RMResearch/OpenMPD_Hardware/README.md

##Main guide in the root folder##

Case designs inside 'cases' have folders for a few designs, NxN where N is the number of boards on the top and bottom of the case

Electronics boards inside 'electronics'
