RMResearch/OpenMPD_Hardware/FPGA_3.4.2/notes.docx

The project: .qpf file

# Top:

Groups all other components, and describes coneections to sub-components and FPGA IO/

## Parallel_Receiver:

Receives USB data and acknowledges (through a PIN).
