RMResearch/OpenMPD_Hardware/Electronics/Controller/Controller Board BOM.xlsx

Sheet: Costing
 | Ident / Locations / Customer Part No. | Description | IF2 Part | Supplier | Part Number | Qty | Cost | Total | Stock | Assy Time | Total Time | Rosh | Reach | Req. | MOQ | EXCESS STOCK VALUE | Assy | Additional | Notes
1 | J3, J4 | SAMTEC TSSH-120-01-L-D | CON2551 | TOBY | TSSH-120-01-L-D | 2 | £2.10 | £4.20 | 1WK | 200.00 | 400.00 |  |  |  |  | £0.00
2 | USB CABLE | Tensility International Corp 10-03678 - USB 2.0, USB 3.2 Gen 2 (USB 3.1 Gen 2, Superspeed+ (USB 3.1)) Cable A Male to C Male 4.92' (1.50m) Shielded | CAB1289 | DIGIKEY | 839-10-03678-ND | 1 | £4.40 | £4.40 | 554 | 60.00 | 60.00 |  |  |  |  | £0.00
3 | AUX | SAMTEC STMM-115-02-L-D | CON2552 | TOBY | STMM-115-02-L-D | 1 | £2.58 | £2.58 | 86 | 150.00 | 150.00
4 | C1 | WALSIN 0805B334K250CT SMD Multilayer Ceramic Capacitor, 0.33 µF, 25 V, 0805 [2012 Metric], ± 10%, X7R | CAP1201 | FARNELL | 2496973RL | 1 | £0.03 | £0.03 | 1410 | 20.00 | 20.00
5 | C2, C7 | AVX 08055C104KAT2A SMD Multilayer Ceramic Capacitor, 0.1 µF, 50 V, 0805 [2012 Metric], ± 10%, X7R | CAP0461 | FARNELL | 499687 | 2 | £0.03 | £0.06 | 797434 | 20.00 | 40.00
6 | C5 | RS PRO 4700μF Electrolytic Capacitor 50V dc, Through Hole | CAP1202 | RSC | 1701262 | 1 | £1.58 | £1.58 | 50 | 45.00 | 45.00
7 | C6 | TAJC106K010RNJ AVX CORPORATION TAJ TANT 10UF 10V 10% CASE C | CAP1096 | ANGLIA COMPONENTS | TAJC106K010RNJ | 1 | £0.10 | £0.10 | 48600 | 20.00 | 20.00 |  |  |  |  | £0.00
8 | C8 | KEMET R82DC3330AA60K - Film Capacitors 63V 0.33uF 10% LS=5mm AEC-Q200 | CAP1203 | MOUSER | 80-R82DC3330AA60K | 1 | £0.11 | £0.11 | 744 | 30.00 | 30.00 |  |  |  |  | £0.00
9 | D1, D2 | DIODES INC S1KB-13-F | DID0634 | RSC | 8855558 | 2 | £0.10 | £0.20 | 3455 | 30.00 | 60.00
10 | HH8, HH9 | SAMTEC SQW-116-01-F-D | CON2553 | TOBY | SQW-116-01-F-D | 2 | £1.95 | £3.90 | 5 DAYS | 160.00 | 320.00
11 | J1, J2 | SAMTEC SQW-127-01-F-D | CON2554 | TOBY | SQW-127-01-F-D | 2 | £3.30 | £6.60 | 5 DAYS | 540.00 | 1080.00
12 | J7, J8 | SAMTEC SSW-111-01-G-S PCB Receptacle, Board-to-Board, 2.54 mm, 1 Rows, 11 Contacts, Through Hole Mount, SSW Series | CON2555 | FARNELL | 2984477 | 2 | £0.80 | £1.60 | 52 | 100.00 | 200.00
13 | K1 | TE PE014003 - General Purpose Relays PE014003 | MEP1082 | MOUSER | 655-PE014003 | 1 | £2.30 | £2.30 | 665 | 45.00 | 45.00 |  |  |  |  | £0.00
14 | L1 | BOURNS 2324-H-RC TOROIDAL INDUCTOR, 1MH, 2.4A, 15% | MEP1083 | FARNELL | 1189587 | 1 | £2.00 | £2.00 | 176 | 30.00 | 30.00 |  |  |  |  | £0.00
 | L1 | HOT MELT GLUE | COS0023 | FARNELL | 704-8117 | 0.01 | £20.00 | £0.20 | STOCK | 45.00 | 45.00
15 | NOT FITTED TO PCB ONLY SUPPLIED WITH CABLE | SAMTEC FFSD-05-D-72.00-01-N | CAB1290 | RSC | 1800017 | 1 | £12.92 | £12.92 | 3 | 60.00 | 60.00 |  |  |  |  | £0.00
18 | PF1 | LITTLEFUSE 1812L110/33MR - Resettable Fuses - PPTC PTC 33V 1.10A POLY SURF MOUNT | MEP1084 | MOUSER | 576-1812L110/33MR | 1 | £0.33 | £0.33 | 9021 | 30.00 | 30.00 |  |  |  |  | £0.00 |  | ASK QUESTION
19 | PF2 | LITTLEFUSE 2920L100PR - Resettable Fuses - PPTC 1.10A 33V 2920 | MEP1085 | MOUSER | 576-2920L100 | 1 | £0.38 | £0.38 | 3654 | 30.00 | 30.00 |  |  |  |  | £0.00 |  | ASK QUESTION
20 | PWR | PCB Mount DC Power Socket 2.1mm Right Angle 2.5A | CON2556 | https://www.hobbytronics.co.uk/ | PRT-00119 | 1 | £0.60 | £0.60 | 8910 | 45.00 | 45.00 |  |  |  |  | £0.00
21 | Q1 | 2N7000 Power MOSFET, N Channel, 60 V, 200 mA, 5 ohm, TO-92, Through Hole | SMC0444 | FARNELL | 9845178 | 1 | £0.10 | £0.10 | 43677 | 45.00 | 45.00 |  |  |  |  | £0.00
22 | UM1 | ADAFRUIT 2264 - Interface Development Tools Adafruit FT232H Breakout - General Purpose USB to GPIO SPI I2C - USB C & Stemma QT | SMC1540 | MOUSER | 485-2264 | 1 | £11.39 | £11.39 | 323 | 120.00 | 120.00 |  |  |  |  | £0.00
23 | VR1 | MURATA OKI-78SR-5/1.5-W36-C - Non-Isolated DC/DC Converters 7.5W 24Vin 5Vout1 1.5A SIP Non-Iso | MEP1086 | MOUSER | 580-OKI78SR5/1.5W36C | 1 | £3.18 | £3.18 | 4195 | 45.00 | 45.00 |  |  |  |  | £0.00
24 | SYNC | SAMTEC SHF-105-01-L-D-RA | CON2557 | TOBY | SHF-105-01-L-D-RA | 1 | £1.71 | £1.71 | 1WK | 100.00 | 100.00 |  |  |  |  | £0.00
25 | VS | WURTH 150080RS75000 | DID0635 | MOUSER | 710-150080RS75000 | 1 | £0.13 | £0.13 | 36635 | 45.00 | 45.00 |  |  |  |  | £0.00
26 | Vin | WURTH 150080VS75000 | DID0636 | MOUSER | 710-150080VS75000 | 1 | £0.13 | £0.13 | 20484 | 45.00 | 45.00 |  |  |  |  | £0.00
27 | Vcc | WURTH 150080BS75000 | DID0637 | MOUSER | 710-150080BS75000 | 1 | £0.13 | £0.13 | 12876 | 45.00 | 45.00 |  |  |  |  | £0.00
28 | Vin SYNC, MS, REF | 2.54mm PITCH 36W SIL PIN HEADER STRIP GOLD PLATED | CON0151 | INTERFACE 2 |  | 1 | £1.50 | £1.50 | STOCK | 30.00 | 180.00 |  |  |  |  | £0.00
29 | R1, R2 | BOURNS CR0805-FX-1501ELF SMD Chip Resistor, 1.5 kohm, ± 1%, 125 mW, 0805 [2012 Metric], Thick Film, General Purpose | RES1766 | FARNELL | 2333560RL | 2 | £0.01 | £0.03 | 1330 | 20.00 | 40.00
30 | R6 | CRCW0805330RFKEA SMD Chip Resistor, 330 ohm, ± 1%, 125 mW, 0805 [2012 Metric], Thick Film, General Purpose | RES0755 | FARNELL | 1469918 | 1 | £0.02 | £0.02 | STOCK | 30.00 | 30.00
31 | R3, R5, R7, R11, R12 | Bourns 10kΩ, 0805 (2012M) Thick Film SMD Resistor ±1% 0.25W - CRS0805-FX-1002ELF | RES1660 | RSC | 8672934 | 5 | £0.06 | £0.32 | 550 | 20.00 | 100.00
32 | Vin SYNC, MS | Amphenol FCI 63429-202LF, Mini-Jump Jumper Female White Shunt 2 Way 1 Row 2.54mm Pitch | MEP1087 | RSC | 8632721 | 2 | £0.13 | £0.25 | STOCK | 20.00 | 40.00
33 | FPGA | COREEP4CE10, ALTERA CORE BOARD | SMC1541 | WAVE SHARE | CoreEP4CE10 | 1 | £22.72 | £22.72 | TBC | 120.00 | 120.00
34 | POWER SUPPLY | Ansmann 12 V dc, 15 V dc, 18 V dc, 19 V dc, 20 V dc, 22 V dc, 24 V dc Power Supply, 1 A, 1.2 A, 1.35 A, 1.4 A, 1.5 A | MEP1088 | RSC | 7023265 | 1 | £20.96 | £20.96 | 22 | 180.00 | 180.00
35 | PCB | PCB | CUS0797 | BEN |  | 1 | £0.00 | £0.00 | STOCK | 600.00 | 600.00

Sheet: Labour only
 |  | Price checked means we have reviewed cheapest buying option on the day costing was created
 |  | All prices are only a guide to what can be paid per component, if a cheaper option exists on Caliach it should be used.
 | Mandatory QMS Information Questions
 | Statutory, Regulatory and Environmental requirements to be considered ? |  |  | All parts supplied to conform to RoHS, and Reach Regulations including conflict minerals act.
 | Any requirements specified by the customer, including the requirements for delivery and post-delivery activities?
 | Customer | BEN @ UCL
 | Customer Part No. | DAUGHTER BOARD (CONTROLLER ASSEMBLY)
 | Interface 2 Part No. | IF25301
 | Issue No. | 01
 | Batch size | 1.00
 | Unit Cost | £45.67
 | Order Value | £45.67
 | Buy Value - Batch | £0.00
 | Labour required in hours | 1.52
 | Value | £32.73
 | Ident / Locations / Customer Part No. | Description | IF2 Part | Supplier | Part Number | Qty | Cost | Total | Stock | Assy Time | Total Time | Rosh | Reach | Req. | MOQ | EXCESS STOCK VALUE | Assy | Additional | Notes
1 | J3, J4 | SAMTEC TSSH-120-01-L-D | CON2551 | TOBY | TSSH-120-01-L-D | 2 |  | £0.00 | 1WK | 200.00 | 400.00 |  |  |  |  | £0.00
2 | USB CABLE | Tensility International Corp 10-03678 - USB 2.0, USB 3.2 Gen 2 (USB 3.1 Gen 2, Superspeed+ (USB 3.1)) Cable A Male to C Male 4.92' (1.50m) Shielded |  | DIGIKEY | 839-10-03678-ND | 1 |  | £0.00 | 554 | 60.00 | 60.00 |  |  |  |  | £0.00
3 | AUX | SAMTEC STMM-115-02-L-D |  | MOUSER | 200-STMM11502LD | 1 |  | £0.00 | 86 | 150.00 | 150.00
4 | C1 | WALSIN 0805B334K250CT SMD Multilayer Ceramic Capacitor, 0.33 µF, 25 V, 0805 [2012 Metric], ± 10%, X7R |  | FARNELL | 2496973RL | 1 |  | £0.00 | 1410 | 20.00 | 20.00
5 | C2, C7 | AVX 08055C104KAT2A SMD Multilayer Ceramic Capacitor, 0.1 µF, 50 V, 0805 [2012 Metric], ± 10%, X7R | CAP0461 | FARNELL | 499687 | 2 |  | £0.00 | 797434 | 20.00 | 40.00
6 | C5 | RS PRO 4700μF Electrolytic Capacitor 50V dc, Through Hole |  | RSC | 1701262 | 1 |  | £0.00 | 50 | 45.00 | 45.00
7 | C6 | TAJC106K010RNJ AVX CORPORATION TAJ TANT 10UF 10V 10% CASE C |  | ANGLIA COMPONENTS | TAJC106K010RNJ | 1 |  | £0.00 | 48600 | 20.00 | 20.00 |  |  |  |  | £0.00
8 | C8 | KEMET R82DC3330AA60K - Film Capacitors 63V 0.33uF 10% LS=5mm AEC-Q200 |  | MOUSER | 80-R82DC3330AA60K | 1 |  | £0.00 | 744 | 30.00 | 30.00 |  |  |  |  | £0.00
9 | D1, D2 | DIODES INC S1KB-13-F |  | RSC | 8855558 | 2 |  | £0.00 | 3455 | 30.00 | 60.00
10 | HH8, HH9 | SAMTEC SQW-116-01-F-D |  | MOUSER | 200-SQW11601FD | 2 |  | £0.00 | 89 | 160.00 | 320.00
11 | J1, J2 | SAMTEC SQW-127-01-F-D |  | NEWARK | 81P1316 | 2 |  | £0.00 | 100 | 540.00 | 1080.00
12 | J7, J8 | V06 Series Valcon 2.54mm Pitch Single Row PCB Mount Socket |  | TOBY | V06-1x10-SV-GF-1 | 2 |  | £0.00 | 1784 | 100.00 | 200.00
13 | K1 | TE PE014003 - General Purpose Relays PE014003 |  | MOUSER | 655-PE014003 | 1 |  | £0.00 | 665 | 45.00 | 45.00 |  |  |  |  | £0.00
14 | L1 | BOURNS 2324-H-RC TOROIDAL INDUCTOR, 1MH, 2.4A, 15% |  | FARNELL | 1189587 | 1 |  | £0.00 | 176 | 30.00 | 30.00 |  |  |  |  | £0.00
15 | NOT FITTED TO PCB ONLY SUPPLIED WITH CABLE | SAMTEC FFSD-05-D-72.00-01-N |  | RSC | 1800017 | 2 |  | £0.00 | 3 | 60.00 | 120.00 |  |  |  |  | £0.00
18 | PF1 | LITTLEFUSE 1812L110/33MR - Resettable Fuses - PPTC PTC 33V 1.10A POLY SURF MOUNT |  | MOUSER | 576-1812L110/33MR | 1 |  | £0.00 | 9021 | 30.00 | 30.00 |  |  |  |  | £0.00 |  | ASK QUESTION
19 | PF2 | LITTLEFUSE 2920L100PR - Resettable Fuses - PPTC 1.10A 33V 2920 |  | MOUSER | 576-2920L100 | 1 |  | £0.00 | 3654 | 30.00 | 30.00 |  |  |  |  | £0.00 |  | ASK QUESTION
20 | PWR | PCB Mount DC Power Socket 2.1mm Right Angle 2.5A |  | https://www.hobbytronics.co.uk/ | PRT-00119 | 1 |  | £0.00 | 8910 | 45.00 | 45.00 |  |  |  |  | £0.00
21 | Q1 | 2N7000 Power MOSFET, N Channel, 60 V, 200 mA, 5 ohm, TO-92, Through Hole |  | FARNELL | 9845178 | 1 |  | £0.00 | 43677 | 45.00 | 45.00 |  |  |  |  | £0.00
22 | UM1 | ADAFRUIT 2264 - Interface Development Tools Adafruit FT232H Breakout - General Purpose USB to GPIO SPI I2C - USB C & Stemma QT |  | MOUSER | 485-2264 | 1 |  | £0.00 | 323 | 120.00 | 120.00 |  |  |  |  | £0.00
23 | VR1 | MURATA OKI-78SR-5/1.5-W36-C - Non-Isolated DC/DC Converters 7.5W 24Vin 5Vout1 1.5A SIP Non-Iso |  | MOUSER | 580-OKI78SR5/1.5W36C | 1 |  | £0.00 | 4195 | 45.00 | 45.00 |  |  |  |  | £0.00
24 | SYNC | SAMTEC SHF-105-01-L-D-RA |  | MOUSER | 200-SHF10501LDRA | 1 |  | £0.00 | 659 | 100.00 | 100.00 |  |  |  |  | £0.00
25 | VS | WURTH 150080RS75000 |  | MOUSER | 710-150080RS75000 | 1 |  | £0.00 | 36635 | 45.00 | 45.00 |  |  |  |  | £0.00
26 | Vin | WURTH 150080VS75000 |  | MOUSER | 710-150080VS75000 | 1 |  | £0.00 | 20484 | 45.00 | 45.00 |  |  |  |  | £0.00
27 | Vcc | WURTH 150080BS75000 |  | MOUSER | 710-150080BS75000 | 1 |  | £0.00 | 12876 | 45.00 | 45.00 |  |  |  |  | £0.00
28 | Vin SYNC, MS, REF | 2.54mm PITCH 36W SIL PIN HEADER STRIP GOLD PLATED | CON0151 | INTERFACE 2 |  | 1 |  | £0.00 | STOCK | 30.00 | 180.00 |  |  |  |  | £0.00
29 | R1, R2 | BOURNS CR0805-FX-1501ELF SMD Chip Resistor, 1.5 kohm, ± 1%, 125 mW, 0805 [2012 Metric], Thick Film, General Purpose | RES1766 | FARNELL | 2333560RL | 2 |  | £0.00 | 1330 | 20.00 | 40.00
30 | R6 | CRCW0805330RFKEA SMD Chip Resistor, 330 ohm, ± 1%, 125 mW, 0805 [2012 Metric], Thick Film, General Purpose |  | FARNELL | 1469918 | 1 |  | £0.00 | STOCK | 30.00 | 30.00
31 | R3, R5, R7, R11, R12 | Vishay Dale Manufacturer Part Number CRCW080510K0FKEAC 10 kOhms ±1% 0.125W, 1/8W Chip Resistor 0805 (2012 Metric) Thick Film |  | DIGIKEY | 541-3976-6-ND | 5 |  | £0.00 | STOCK | 20.00 | 100.00
32 | Vin SYNC, MS | Amphenol FCI 63429-202LF, Mini-Jump Jumper Female White Shunt 2 Way 1 Row 2.54mm Pitch |  | RSC | 8632721 | 2 |  | £0.00 | STOCK | 20.00 | 40.00
33 | FPGA | COREEP4CE10, ALTERA CORE BOARD |  | WAVE SHARE | CoreEP4CE10 | 1 |  | £0.00 | TBC | 120.00 | 120.00
34 | POWER SUPPLY | HNP 72-UNI Universal power supply, 72 W, out 12 - 24 V |  | GES HmbH | HNP 72-UNI | 1 |  | £0.00 | 22 | 180.00 | 180.00
35 | PCB | PCB |  | BEN |  | 1 |  | £0.00 | STOCK | 600.00 | 600.00
36 |  | PROCUREMENT |  |  |  | 25% |  | £0.00 | LABOUR
37 |  | LABOUR |  |  |  | 74.33 | £0.50 | £37.17 | 1.24
38 |  | INSPECTION |  |  |  | 15.00 | £0.50 | £7.50 | 0.25
39 |  | PACKING |  |  |  | 2.00 | £0.50 | £1.00 | 0.03
40 |  | SM MACHINE PROGRAMMING |  |  |  | 0.00 | £0.50 | £0.00 | 0.00
41 |  | SM MACHINE SET UP |  |  |  | 0.00 | £0.50 | £0.00 | 0.00
42 |  | TOOLING COSTS |  |  |  | £0.00 | 100% | £0.00
43 |  | EXCESS STOCK |  |  |  | £0.00 | 100% | £0.00
44 |  | DELIVERY CHARGES |  | WAVESHARE, HOBBYCRAFT |  | £59.00 | 100% | £0.00
45 |  | TOTAL |  |  |  |  |  | £45.67 | 1.52
 | EXT | SAMTEC SQW-116-01-F-D |  | MOUSER | 200-SQW11601FD | 1 | £2.44 | £2.44 | 89 | 160.00 | 160.00 |  |  |  |  |  |  | FIT IF THERE IS SPACE AFTER 1st BOARD HAS BEEN BUILT.
 |  | SMATEC FFSD-05-01-N IDC Connector, IDC Receptacle, Female, 1.27 mm, 2 Row, 10 Contacts, Cable Mount |  | FARNELL | 1753841 | 2 | £3.65 | £7.30
 |  | PRO POWER R2651DTSY10SC85 Ribbon Cable, Per Metre, Unscreened, 10 Core, 28 AWG |  | FARNELL | 2628362 | 0.1 | £0.86 | £0.09
 |  |  |  |  |  |  |  | £2.22
 |  |  |  |  |  | 6 | £0.50 | £3.00
 |  |  |  |  |  | 1 | £0.50 | £0.50
 |  |  |  |  |  |  |  | £13.10
