RMResearch/OpenMPD_Hardware/Electronics/Array/Array Board BOM.xlsx

 |  | Price checked means we have reviewed cheapest buying option on the day costing was created
 |  | All prices are only a guide to what can be paid per component, if a cheaper option exists on Caliach it should be used.
 | Mandatory QMS Information Questions
 | Statutory, Regulatory and Environmental requirements to be considered ? |  |  | All parts supplied to conform to RoHS, and Reach Regulations including conflict minerals act.
 | Any requirements specified by the customer, including the requirements for delivery and post-delivery activities?
 | Customer | BEN @ UCL
 | Customer Part No. | MOTHERBOARD
 | Interface 2 Part No. | IF25273
 | Issue No. | 01
 | Batch size | 8.00
 | Unit Cost | £270.95
 | Order Value | £2167.57
 | Buy Value - Batch | £660.69
 | Labour required in hours | 43.62
 | Value | £1136.09
 | Ident / Locations / Customer Part No. | Description | IF2 Part | Supplier | Part Number | Qty | Cost | Total | Stock | Assy Time | Total Time | Rosh | Reach | Req. | MOQ | EXCESS STOCK VALUE | Assy | Additional | Notes
1 | U5[, U5\, U5], U5^, U5_, U5`, U5A, U5B, U5C, U5D, U5E, U5F, U5G, U5H, U5I, U5J, U5K, U5L, U5M, U5N, U5O, U5P, U5Q, U5R, U5S, U5T, U5U, U5V, U5W, U5X, U5Y, U5Z | 74HC595D,118 Shift Register, 74HC595, Serial to Parallel, Serial to Serial, 1 Element, 8 bit, SOIC, 16 Pins | SMC1538 | FARNELL | 1201269 | 32 | £0.10 | £3.36 | 5364 | 20.00 | 640.00 |  |  |  |  | £0.00
2 | C1[, C1\, C1], C1^, C1_, C1`, C1A, C1B, C1C, C1D, C1E, C1F, C1G, C1H, C1I, C1J, C1K, C1L, C1M, C1N, C1O, C1P, C1Q, C1R, C1S, C1T, C1U, C1V, C1W, C1X, C1Y, C1Z, C2[, C2\, C2], C2^, C2_, C2`, C2A, C2B, C2C, C2D, C2E, C2F, C2G, C2H, C2I, C2J, C2K, C2L, C2M, C2N, C2O, C2P, C2Q, C2R, C2S, C2T, C2U, C2V, C2W, C2X, C2Y, C2Z, C4[, C4\, C4], C4^, C4_, C4`, C4A, C4B, C4C, C4D, C4E, C4F, C4G, C4H, C4I, C4J, C4K, C4L, C4M, C4N, C4O, C4P, C4Q, C4R, C4S, C4T, C4U, C4V, C4W, C4X, C4Y, C4Z, C6[, C6\, C6], C6^, C6_, C6`, C6A, C6B, C6C, C6D, C6E, C6F, C6G, C6H, C6I, C6J, C6K, C6L, C6M, C6N, C6O, C6P, C6Q, C6R, C6S, C6T, C6U, C6V, C6W, C6X, C6Y, C6Z, C8[, C8\, C8], C8^, C8_, C8`, C8A, C8B, C8C, C8D, C8E, C8F, C8G, C8H, C8I, C8J, C8K, C8L, C8M, C8N, C8O, C8P, C8Q, C8R, C8S, C8T, C8U, C8V, C8W, C8X, C8Y, C8Z | CL21B104MBCNNNC SMD Multilayer Ceramic Capacitor, 0.1 µF, 50 V, 0805 [2012 Metric], ± 20%, X7R, CL Series | CAP1200 | FARNELL | 3010152 | 160 | £0.01 | £1.28 | 168000 | 20.00 | 3200.00 |  |  |  |  | £0.00
3 | U1[, U1\, U1], U1^, U1_, U1`, U1A, U1B, U1C, U1D, U1E, U1F, U1G, U1H, U1I, U1J, U1K, U1L, U1M, U1N, U1O, U1P, U1Q, U1R, U1S, U1T, U1U, U1V, U1W, U1X, U1Y, U1Z, U2[, U2\, U2], U2^, U2_, U2`, U2A, U2B, U2C, U2D, U2E, U2F, U2G, U2H, U2I, U2J, U2K, U2L, U2M, U2N, U2O, U2P, U2Q, U2R, U2S, U2T, U2U, U2V, U2W, U2X, U2Y, U2Z, U3[, U3\, U3], U3^, U3_, U3`, U3A, U3B, U3C, U3D, U3E, U3F, U3G, U3H, U3I, U3J, U3K, U3L, U3M, U3N, U3O, U3P, U3Q, U3R, U3S, U3T, U3U, U3V, U3W, U3X, U3Y, U3Z, U4[, U4\, U4], U4^, U4_, U4`, U4A, U4B, U4C, U4D, U4E, U4F, U4G, U4H, U4I, U4J, U4K, U4L, U4M, U4N, U4O, U4P, U4Q, U4R, U4S, U4T, U4U, U4V, U4W, U4X, U4Y, U4Z | MIC4127YME SOIC 1.5A DUAL HIGH SPEED MOSFET DRIVER WITH LOW THERMAL IMPEDANCE ROHS COMPLIANT: YES - SOIC-8 | SMC1539 | NEWARK | 79AH4289 | 128 | £0.58 | £74.35 | 2630 | 20.00 | 2560.00 |  |  |  |  | £0.00
 | 1#, 1-, 1[, 1\, 1], 1_, 1A, 1B, 1C, 1D, 1E, 1F, 1G, 1H, 1I, 1J, 1K, 1L, 1M, 1N, 1O, 1P, 1Q, 1R, 1S, 1T, 1U, 1V, 1W, 1X, 1Y, 1Z, 2#, 2-, 2[, 2\, 2], 2_, 2A, 2B, 2C, 2D, 2E, 2F, 2G, 2H, 2I, 2J, 2K, 2L, 2M, 2N, 2O, 2P, 2Q, 2R, 2S, 2T, 2U, 2V, 2W, 2X, 2Y, 2Z, 3#, 3-, 3[, 3\, 3], 3_, 3A, 3B, 3C, 3D, 3E, 3F, 3G, 3H, 3I, 3J, 3K, 3L, 3M, 3N, 3O, 3P, 3Q, 3R, 3S, 3T, 3U, 3V, 3W, 3X, 3Y, 3Z, 4#, 4-, 4[, 4\, 4], 4_, 4A, 4B, 4C, 4D, 4E, 4F, 4G, 4H, 4I, 4J, 4K, 4L, 4M, 4N, 4O, 4P, 4Q, 4R, 4S, 4T, 4U, 4V, 4W, 4X, 4Y, 4Z, 5#, 5-, 5[, 5\, 5], 5_, 5A, 5B, 5C, 5D, 5E, 5F, 5G, 5H, 5I, 5J, 5K, 5L, 5M, 5N, 5O, 5P, 5Q, 5R, 5S, 5T, 5U, 5V, 5W, 5X, 5Y, 5Z, 6#, 6-, 6[, 6\, 6], 6_, 6A, 6B, 6C, 6D, 6E, 6F, 6G, 6H, 6I, 6J, 6K, 6L, 6M, 6N, 6O, 6P, 6Q, 6R, 6S, 6T, 6U, 6V, 6W, 6X, 6Y, 6Z, 7#, 7-, 7[, 7\, 7], 7_, 7A, 7B, 7C, 7D, 7E, 7F, 7G, 7H, 7I, 7J, 7K, 7L, 7M, 7N, 7O, 7P, 7Q, 7R, 7S, 7T, 7U, 7V, 7W, 7X, 7Y, 7Z, 8#, 8-, 8[, 8\, 8], 8_, 8A, 8B, 8C, 8D, 8E, 8F, 8G, 8H, 8I, 8J, 8K, 8L, 8M, 8N, 8O, 8P, 8Q, 8R, 8S, 8T, 8U, 8V, 8W, 8X, 8Y, 8Z | TRANSDUCER | CUS0803 | BEN UCL |  | 256 | £0.00 | £0.00 |  | 45.00 | 11520.00
 |  | TRANSDUCER PCB | CUS0802 | BEN |  | 1 | £0.00 | £0.00 | 20 | 600.00 | 600.00
4 | Header1, Header2 | B27c-2x20-BSBB1-G - B27c - Valcon 2.54mm Dual Row Surface Mount Socket Strip, 7.1mm Profile | CON2544 | TOBY | B27c-2x20-BSBB1-G | 2 | £1.80 | £3.60 | 100 | 45.00 | 90.00 |  |  |  |  | £0.00
76 |  | PROCUREMENT |  |  |  | 30% |  | £24.78 | LABOUR
77 |  | LABOUR |  |  |  | 310.17 | £0.50 | £155.08 | 41.36
78 |  | INSPECTION |  |  |  | 15.00 | £0.50 | £7.50 | 2.00
79 |  | PACKING |  |  |  | 2.00 | £0.50 | £1.00 | 0.27
80 |  | SM MACHINE PROGRAMMING |  |  |  | 0.00 | £0.50 | £0.00 | 0.00
81 |  | SM MACHINE SET UP |  |  |  | 0.00 | £0.50 | £0.00 | 0.00
82 |  | TOOLING COSTS |  |  |  | £0.00 | 12.5% | £0.00
83 |  | EXCESS STOCK |  |  |  | £0.00 | 12.5% | £0.00
84 |  | DELIVERY CHARGES |  |  |  | £0.00 | 12.5% | £0.00
85 |  | TOTAL |  |  |  |  |  | £270.95 | 43.62
 | Customer | BEN @ UCL
 | Customer Part No. | MOTHERBOARD
 | Interface 2 Part No. | IF25273 - LABOUR ONLY
 | Issue No. | 01
 | Batch size | 8.00
 | Unit Cost | £0.00
 | Order Value | £0.00
 | Buy Value - Batch | £0.00
 | Ident / Locations / Customer Part No. | Description | IF2 Part | Supplier | Part Number | Qty | Cost | Total | Stock | Assy Time | Total Time | Rosh | Reach | Req. | MOQ | EXCESS STOCK VALUE | Assy | Additional | Notes
1 | U5[, U5\, U5], U5^, U5_, U5`, U5A, U5B, U5C, U5D, U5E, U5F, U5G, U5H, U5I, U5J, U5K, U5L, U5M, U5N, U5O, U5P, U5Q, U5R, U5S, U5T, U5U, U5V, U5W, U5X, U5Y, U5Z | 74HC595D,118 Shift Register, 74HC595, Serial to Parallel, Serial to Serial, 1 Element, 8 bit, SOIC, 16 Pins | SMC1538 | FARNELL | 1201269 | 32 | £0.00 | £0.00 | 5364 | 20.00 | 640.00 |  |  |  |  | £0.00
2 | C1[, C1\, C1], C1^, C1_, C1`, C1A, C1B, C1C, C1D, C1E, C1F, C1G, C1H, C1I, C1J, C1K, C1L, C1M, C1N, C1O, C1P, C1Q, C1R, C1S, C1T, C1U, C1V, C1W, C1X, C1Y, C1Z, C2[, C2\, C2], C2^, C2_, C2`, C2A, C2B, C2C, C2D, C2E, C2F, C2G, C2H, C2I, C2J, C2K, C2L, C2M, C2N, C2O, C2P, C2Q, C2R, C2S, C2T, C2U, C2V, C2W, C2X, C2Y, C2Z, C4[, C4\, C4], C4^, C4_, C4`, C4A, C4B, C4C, C4D, C4E, C4F, C4G, C4H, C4I, C4J, C4K, C4L, C4M, C4N, C4O, C4P, C4Q, C4R, C4S, C4T, C4U, C4V, C4W, C4X, C4Y, C4Z, C6[, C6\, C6], C6^, C6_, C6`, C6A, C6B, C6C, C6D, C6E, C6F, C6G, C6H, C6I, C6J, C6K, C6L, C6M, C6N, C6O, C6P, C6Q, C6R, C6S, C6T, C6U, C6V, C6W, C6X, C6Y, C6Z, C8[, C8\, C8], C8^, C8_, C8`, C8A, C8B, C8C, C8D, C8E, C8F, C8G, C8H, C8I, C8J, C8K, C8L, C8M, C8N, C8O, C8P, C8Q, C8R, C8S, C8T, C8U, C8V, C8W, C8X, C8Y, C8Z | CL21B104MBCNNNC SMD Multilayer Ceramic Capacitor, 0.1 µF, 50 V, 0805 [2012 Metric], ± 20%, X7R, CL Series | CAP1200 | FARNELL | 3010152 | 160 | £0.00 | £0.00 | 168000 | 20.00 | 3200.00 |  |  |  |  | £0.00
3 | U1[, U1\, U1], U1^, U1_, U1`, U1A, U1B, U1C, U1D, U1E, U1F, U1G, U1H, U1I, U1J, U1K, U1L, U1M, U1N, U1O, U1P, U1Q, U1R, U1S, U1T, U1U, U1V, U1W, U1X, U1Y, U1Z, U2[, U2\, U2], U2^, U2_, U2`, U2A, U2B, U2C, U2D, U2E, U2F, U2G, U2H, U2I, U2J, U2K, U2L, U2M, U2N, U2O, U2P, U2Q, U2R, U2S, U2T, U2U, U2V, U2W, U2X, U2Y, U2Z, U3[, U3\, U3], U3^, U3_, U3`, U3A, U3B, U3C, U3D, U3E, U3F, U3G, U3H, U3I, U3J, U3K, U3L, U3M, U3N, U3O, U3P, U3Q, U3R, U3S, U3T, U3U, U3V, U3W, U3X, U3Y, U3Z, U4[, U4\, U4], U4^, U4_, U4`, U4A, U4B, U4C, U4D, U4E, U4F, U4G, U4H, U4I, U4J, U4K, U4L, U4M, U4N, U4O, U4P, U4Q, U4R, U4S, U4T, U4U, U4V, U4W, U4X, U4Y, U4Z | MIC4127YME SOIC 1.5A DUAL HIGH SPEED MOSFET DRIVER WITH LOW THERMAL IMPEDANCE ROHS COMPLIANT: YES - SOIC-8 | SMC1539 | NEWARK | 79AH4289 | 128 | £0.00 | £0.00 | 2630 | 20.00 | 2560.00 |  |  |  |  | £0.00
 | 1#, 1-, 1[, 1\, 1], 1_, 1A, 1B, 1C, 1D, 1E, 1F, 1G, 1H, 1I, 1J, 1K, 1L, 1M, 1N, 1O, 1P, 1Q, 1R, 1S, 1T, 1U, 1V, 1W, 1X, 1Y, 1Z, 2#, 2-, 2[, 2\, 2], 2_, 2A, 2B, 2C, 2D, 2E, 2F, 2G, 2H, 2I, 2J, 2K, 2L, 2M, 2N, 2O, 2P, 2Q, 2R, 2S, 2T, 2U, 2V, 2W, 2X, 2Y, 2Z, 3#, 3-, 3[, 3\, 3], 3_, 3A, 3B, 3C, 3D, 3E, 3F, 3G, 3H, 3I, 3J, 3K, 3L, 3M, 3N, 3O, 3P, 3Q, 3R, 3S, 3T, 3U, 3V, 3W, 3X, 3Y, 3Z, 4#, 4-, 4[, 4\, 4], 4_, 4A, 4B, 4C, 4D, 4E, 4F, 4G, 4H, 4I, 4J, 4K, 4L, 4M, 4N, 4O, 4P, 4Q, 4R, 4S, 4T, 4U, 4V, 4W, 4X, 4Y, 4Z, 5#, 5-, 5[, 5\, 5], 5_, 5A, 5B, 5C, 5D, 5E, 5F, 5G, 5H, 5I, 5J, 5K, 5L, 5M, 5N, 5O, 5P, 5Q, 5R, 5S, 5T, 5U, 5V, 5W, 5X, 5Y, 5Z, 6#, 6-, 6[, 6\, 6], 6_, 6A, 6B, 6C, 6D, 6E, 6F, 6G, 6H, 6I, 6J, 6K, 6L, 6M, 6N, 6O, 6P, 6Q, 6R, 6S, 6T, 6U, 6V, 6W, 6X, 6Y, 6Z, 7#, 7-, 7[, 7\, 7], 7_, 7A, 7B, 7C, 7D, 7E, 7F, 7G, 7H, 7I, 7J, 7K, 7L, 7M, 7N, 7O, 7P, 7Q, 7R, 7S, 7T, 7U, 7V, 7W, 7X, 7Y, 7Z, 8#, 8-, 8[, 8\, 8], 8_, 8A, 8B, 8C, 8D, 8E, 8F, 8G, 8H, 8I, 8J, 8K, 8L, 8M, 8N, 8O, 8P, 8Q, 8R, 8S, 8T, 8U, 8V, 8W, 8X, 8Y, 8Z | TRANSDUCER | CUS0803 | BEN UCL |  | 256 | £0.00 | £0.00 |  | 45.00 | 11520.00
 |  | TRANSDUCER PCB | CUS0802 | BEN |  | 1 | £0.00 | £0.00 | 20 | 600.00 | 600.00
4 | Header1, Header2 | B27c-2x20-BSBB1-G - B27c - Valcon 2.54mm Dual Row Surface Mount Socket Strip, 7.1mm Profile | CON2544 | TOBY | B27c-2x20-BSBB1-G | 2 | £0.00 | £0.00 | 100 | 45.00 | 90.00 |  |  |  |  | £0.00
