RMResearch/OpenMPD_Hardware/Cases/1x1 Rear Pillars/Final DXFs/3 mm/leap spacer.dxf

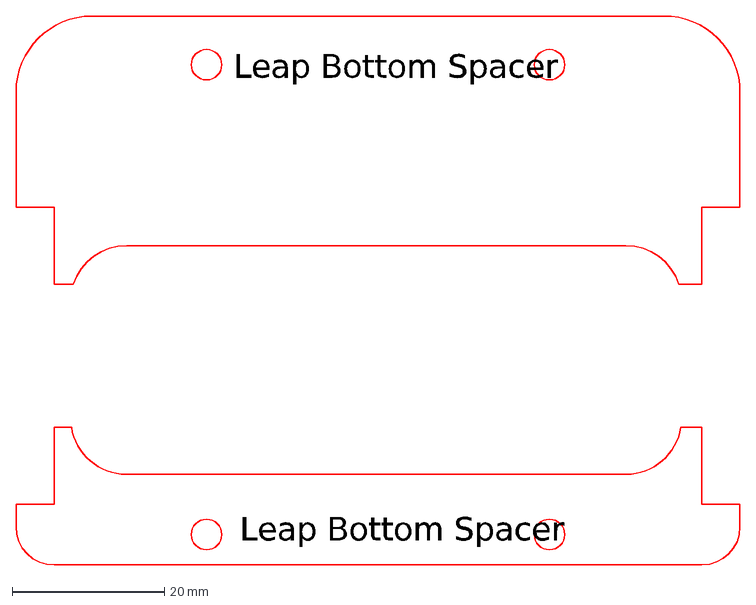
[picture p1: CAD file, 2023-02-06]
Cases/1x1 Rear Pillars/Final DXFs/3 mm/leap spacer.dxf
Leap Bottom Spacer
