RMResearch/OpenMPD_Hardware/Cases/1x1 Rear Pillars/Final DXFs/5mm/2x side bracers.dxf

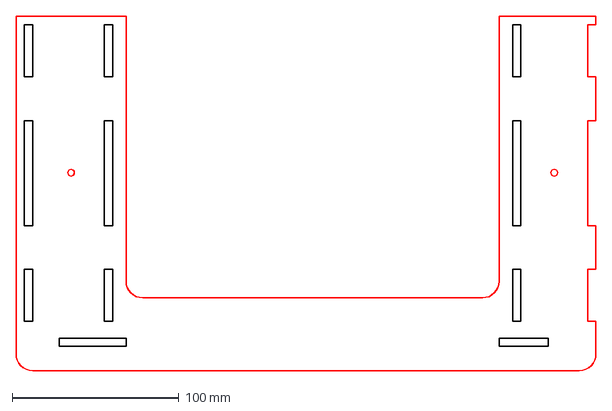
[picture p2: CAD file, 2023-02-06]
Cases/1x1 Rear Pillars/Final DXFs/5mm/2x side bracers.dxf
348.0 x 212.5 mm
