RMResearch/OpenMPD_Hardware/Cases/1x1 Rear Pillars/Model/noctua-nf-a4x10-1.snapshot.1/Noctua-NF-A4x10.STEP

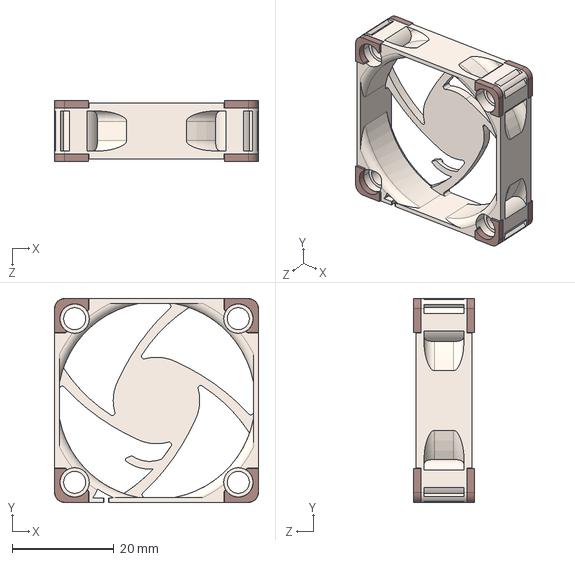
[picture p3: CAD file, 2023-02-06]
Cases/1x1 Rear Pillars/Model/noctua-nf-a4x10-1.snapshot.1/Noctua-NF-A4x10.STEP
40.1 x 40.1 x 12.0 mm
