RMResearch/OpenMPD_Hardware/Cases/2x2/2x2 DXFs/botton fromt.dxf

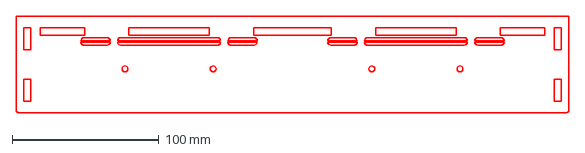
[picture p4: CAD file, 2023-02-06]
Cases/2x2/2x2 DXFs/botton fromt.dxf
376.0 x 66.0 mm
