RMResearch/OpenMPD_Hardware/Cases/1x1 middle pillars/2D Models/DXFs/5mm_BottomCaseBack.dxf

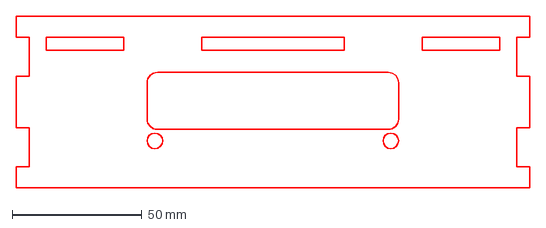
[picture p5: CAD file, 2023-02-06]
Cases/1x1 middle pillars/2D Models/DXFs/5mm_BottomCaseBack.dxf
198.0 x 66.0 mm
