RMResearch/OpenMPD_Hardware/Cases/1x1 Rear Pillars/Final DXFs/3 mm/2x V3 PCB Protector.dxf

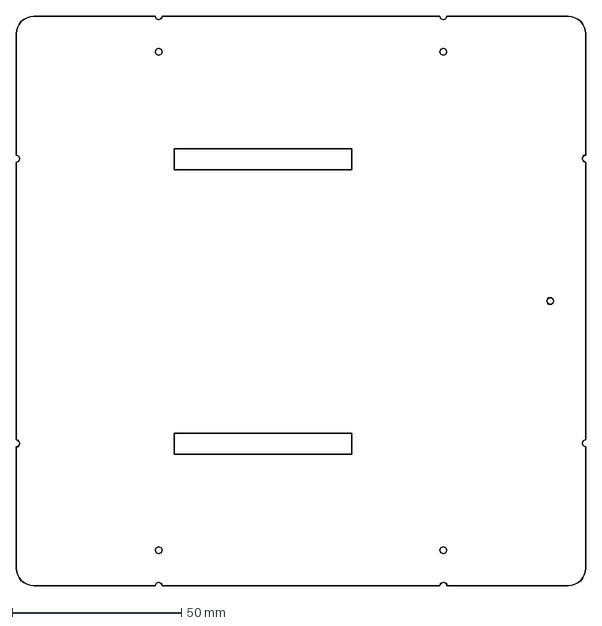
[picture p6: CAD file, 2023-02-06]
Cases/1x1 Rear Pillars/Final DXFs/3 mm/2x V3 PCB Protector.dxf
168.0 x 168.0 mm
