RMResearch/OpenMPD_Hardware/Cases/1x1 Rear Pillars/Final DXFs/5mm/back bracer.dxf

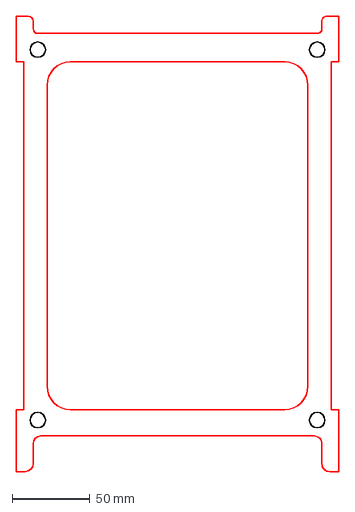
[picture p7: CAD file, 2023-02-06]
Cases/1x1 Rear Pillars/Final DXFs/5mm/back bracer.dxf
208.0 x 293.3 mm
