RMResearch/OpenMPD_Hardware/Cases/2x2/2x2 DXFs/back bracer big.dxf

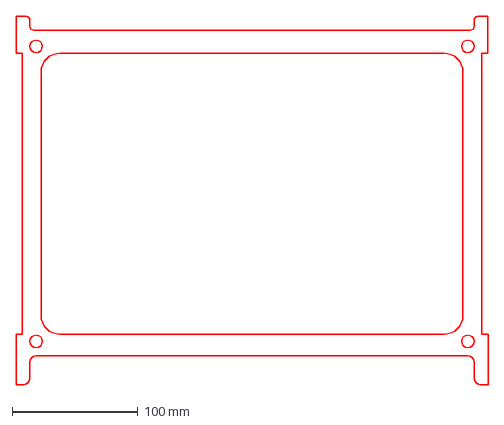
[picture p8: CAD file, 2023-02-06]
Cases/2x2/2x2 DXFs/back bracer big.dxf
376.0 x 293.3 mm
