RMResearch/OpenMPD_Hardware/Cases/1x1 middle pillars/2D Models/DXFs/5mm_TopCaseBack.dxf

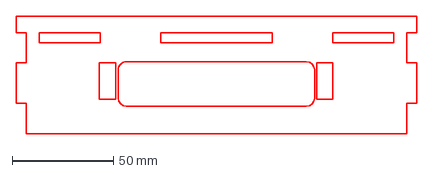
[picture p9: CAD file, 2023-02-06]
Cases/1x1 middle pillars/2D Models/DXFs/5mm_TopCaseBack.dxf
198.0 x 58.0 mm
