RMResearch/OpenMPD_Hardware/Cases/1x1 Rear Pillars/Final DXFs/5mm/bottom back.dxf

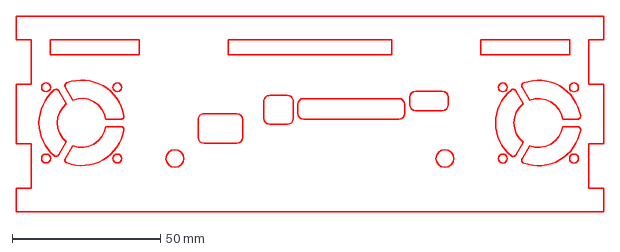
[picture p10: CAD file, 2023-02-06]
Cases/1x1 Rear Pillars/Final DXFs/5mm/bottom back.dxf
198.0 x 66.0 mm
