RMResearch/OpenMPD_Hardware/Cases/2x2/2x2 DXFs/top front.dxf

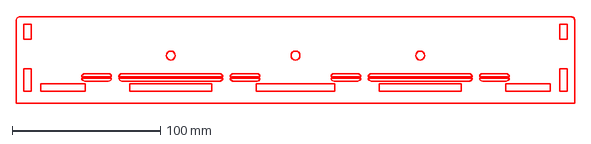
[picture p11: CAD file, 2023-02-06]
Cases/2x2/2x2 DXFs/top front.dxf
376.0 x 58.0 mm
