RMResearch/OpenMPD_Hardware/Cases/1x1 middle pillars/2D Models/DXFs/5mm_2x_bottomCaseSides.dxf

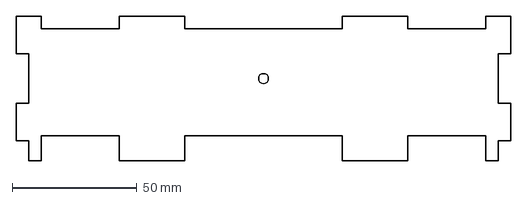
[picture p12: CAD file, 2023-02-06]
Cases/1x1 middle pillars/2D Models/DXFs/5mm_2x_bottomCaseSides.dxf
198.0 x 58.0 mm
