RMResearch/OpenMPD_Hardware/Cases/1x1 Rear Pillars/Final DXFs/3 mm/2x fabric left side.dxf

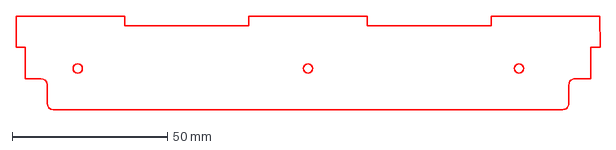
[picture p13: CAD file, 2023-02-06]
Cases/1x1 Rear Pillars/Final DXFs/3 mm/2x fabric left side.dxf
188.0 x 30.0 mm
