RMResearch/OpenMPD_Hardware/Cases/1x1 Rear Pillars/Final DXFs/5mm/6x short spacer.dxf

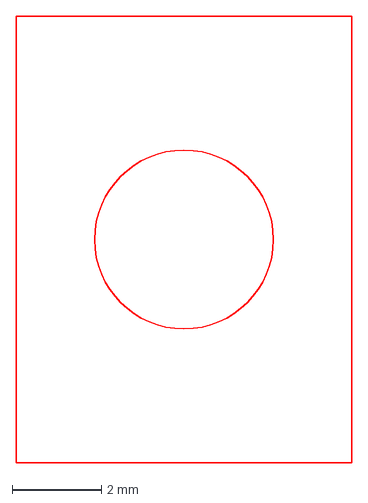
[picture p14: CAD file, 2023-02-06]
Cases/1x1 Rear Pillars/Final DXFs/5mm/6x short spacer.dxf
7.50 x 10.0 mm
