RMResearch/OpenMPD_Hardware/Cases/2x2/2x2 DXFs/2x bottom cover.dxf

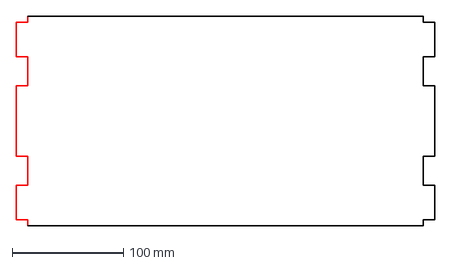
[picture p15: CAD file, 2023-02-06]
Cases/2x2/2x2 DXFs/2x bottom cover.dxf
376.0 x 188.0 mm
