RMResearch/OpenMPD_Hardware/Cases/1x1 middle pillars/2D Models/DXFs/5mm_2x_SideBracers.dxf

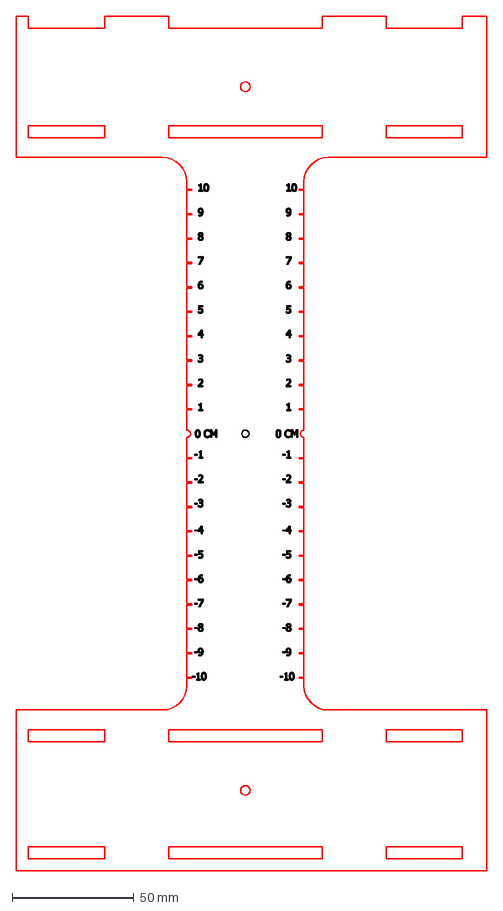
[picture p16: CAD file, 2023-02-06]
Cases/1x1 middle pillars/2D Models/DXFs/5mm_2x_SideBracers.dxf
193.0 x 350.5 mm
