RMResearch/OpenMPD_Hardware/Cases/1x1 Rear Pillars/Final DXFs/3 mm/fabric clamp.dxf

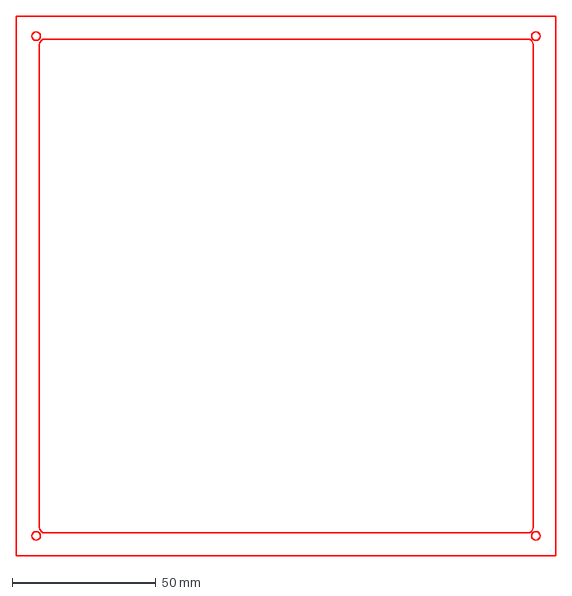
[picture p17: CAD file, 2023-02-06]
Cases/1x1 Rear Pillars/Final DXFs/3 mm/fabric clamp.dxf
188.0 x 188.0 mm
