RMResearch/OpenMPD_Hardware/Cases/1x1 Rear Pillars/Final DXFs/5mm/2x  board cover.dxf

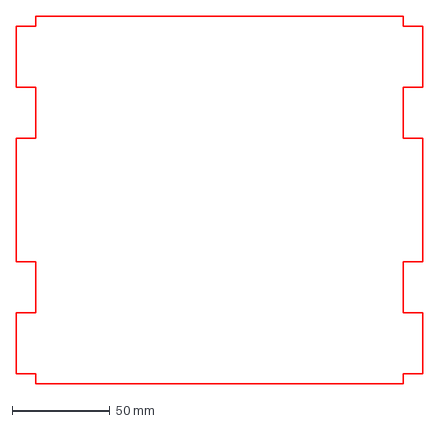
[picture p18: CAD file, 2023-02-06]
Cases/1x1 Rear Pillars/Final DXFs/5mm/2x board cover.dxf
208.0 x 188.0 mm
