RMResearch/OpenMPD_Hardware/Cases/2x2/2x2 DXFs/bottom back.dxf

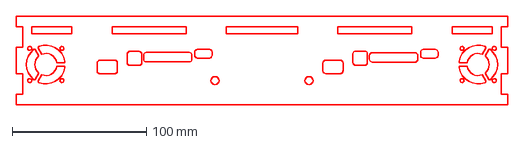
[picture p19: CAD file, 2023-02-06]
Cases/2x2/2x2 DXFs/bottom back.dxf
366.0 x 66.0 mm
