RMResearch/OpenMPD_Hardware/Cases/1x1 middle pillars/2D Models/DXFs/5mm_TopCaseFront.dxf

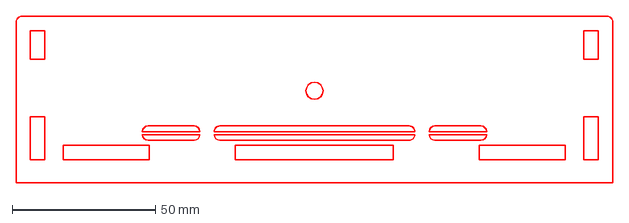
[picture p20: CAD file, 2023-02-06]
Cases/1x1 middle pillars/2D Models/DXFs/5mm_TopCaseFront.dxf
208.0 x 58.0 mm
