RMResearch/OpenMPD_Hardware/Cases/1x1 Rear Pillars/Final DXFs/5mm/2x top sides.dxf

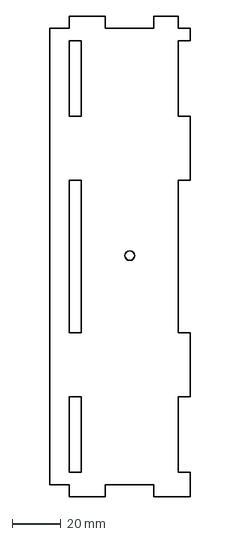
[picture p21: CAD file, 2023-02-06]
Cases/1x1 Rear Pillars/Final DXFs/5mm/2x top sides.dxf
58.0 x 198.0 mm
