RMResearch/OpenMPD_Hardware/Cases/2x2/2x2 DXFs/top back.dxf

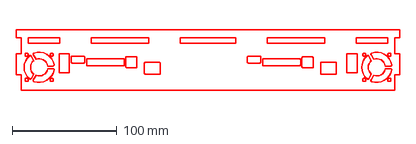
[picture p22: CAD file, 2023-02-06]
Cases/2x2/2x2 DXFs/top back.dxf
366.0 x 58.0 mm
