RMResearch/OpenMPD_Hardware/Cases/1x1 middle pillars/2D Models/DXFs/5mm_BottomCaseBoardHolder.dxf

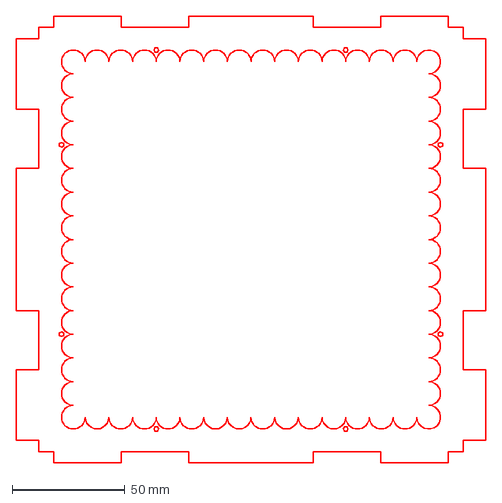
[picture p23: CAD file, 2023-02-06]
Cases/1x1 middle pillars/2D Models/DXFs/5mm_BottomCaseBoardHolder.dxf
208.0 x 198.0 mm
