RMResearch/OpenMPD_Hardware/Cases/1x1 Rear Pillars/Final DXFs/3 mm/leap ap.dxf

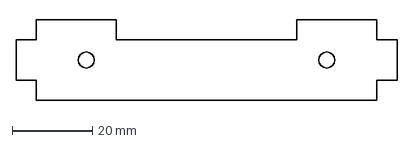
[picture p24: CAD file, 2023-02-06]
Cases/1x1 Rear Pillars/Final DXFs/3 mm/leap ap.dxf
95.0 x 20.0 mm
