RMResearch/OpenMPD_Hardware/Cases/1x1 Rear Pillars/Final DXFs/5mm/top front.dxf

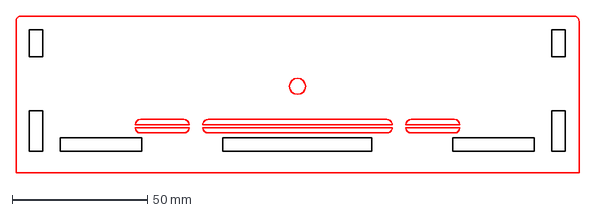
[picture p25: CAD file, 2023-02-06]
Cases/1x1 Rear Pillars/Final DXFs/5mm/top front.dxf
208.0 x 58.0 mm
