RMResearch/OpenMPD_Hardware/Cases/2x2/2x2 DXFs/2x board holder.dxf

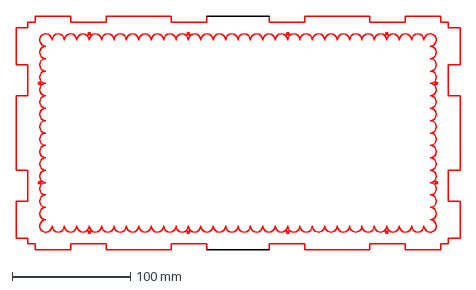
[picture p26: CAD file, 2023-02-06]
Cases/2x2/2x2 DXFs/2x board holder.dxf
376.0 x 198.0 mm
