RMResearch/OpenMPD_Hardware/Cases/1x1 middle pillars/2D Models/DXFs/5mm_TopCaseBoardHolder.dxf

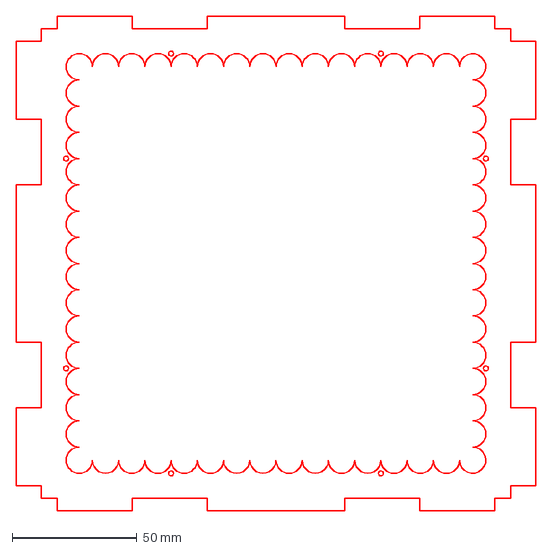
[picture p27: CAD file, 2023-02-06]
Cases/1x1 middle pillars/2D Models/DXFs/5mm_TopCaseBoardHolder.dxf
208.0 x 198.0 mm
