RMResearch/OpenMPD_Hardware/Cases/1x1 Rear Pillars/Final DXFs/3 mm/leap bottom base.dxf

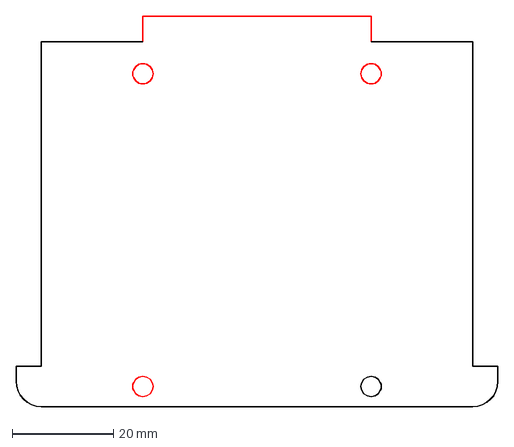
[picture p28: CAD file, 2023-02-06]
Cases/1x1 Rear Pillars/Final DXFs/3 mm/leap bottom base.dxf
95.0 x 77.0 mm
