RMResearch/OpenMPD_Hardware/Cases/2x2/2x2 DXFs/2x Top sides.dxf

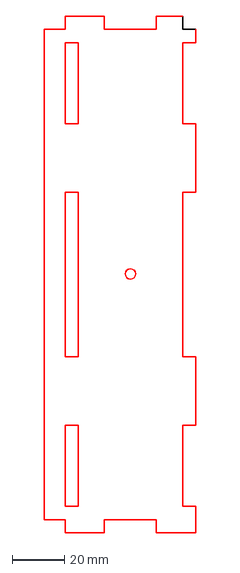
[picture p29: CAD file, 2023-02-06]
Cases/2x2/2x2 DXFs/2x Top sides.dxf
58.0 x 198.0 mm
