RMResearch/OpenMPD_Hardware/Cases/1x1 middle pillars/2D Models/DXFs/5mm_TopCaseCover.dxf

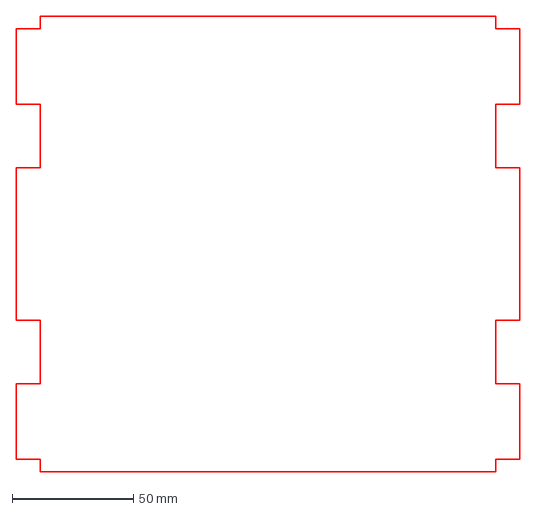
[picture p30: CAD file, 2023-02-06]
Cases/1x1 middle pillars/2D Models/DXFs/5mm_TopCaseCover.dxf
208.0 x 188.0 mm
