RMResearch/OpenMPD_Hardware/Cases/1x1 Rear Pillars/Final DXFs/3 mm/2x leap side.dxf

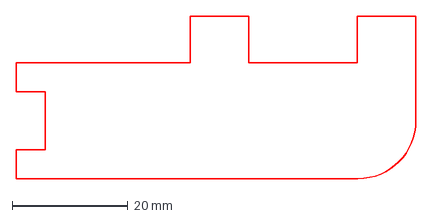
[picture p31: CAD file, 2023-02-06]
Cases/1x1 Rear Pillars/Final DXFs/3 mm/2x leap side.dxf
69.0 x 28.0 mm
