RMResearch/OpenMPD_Hardware/Cases/1x1 Rear Pillars/Final DXFs/5mm/2x board holder.dxf

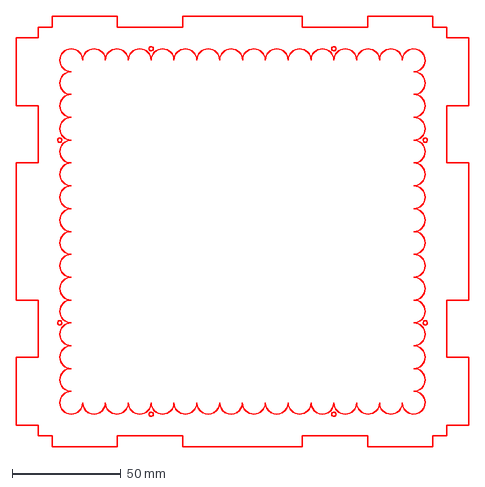
[picture p32: CAD file, 2023-02-06]
Cases/1x1 Rear Pillars/Final DXFs/5mm/2x board holder.dxf
208.0 x 198.0 mm
