RMResearch/OpenMPD_Hardware/Cases/2x2/2x2 DXFs/2z bottom sides.dxf

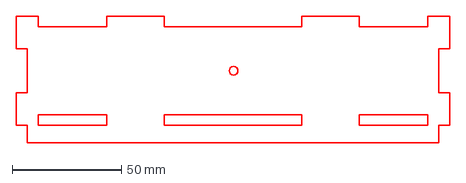
[picture p33: CAD file, 2023-02-06]
Cases/2x2/2x2 DXFs/2z bottom sides.dxf
198.0 x 58.0 mm
