RMResearch/OpenMPD_Hardware/Cases/1x1 middle pillars/2D Models/DXFs/5mm_2x_TopCaseSides.dxf

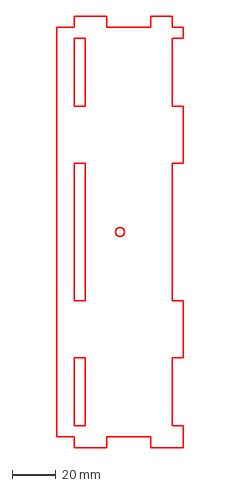
[picture p34: CAD file, 2023-02-06]
Cases/1x1 middle pillars/2D Models/DXFs/5mm_2x_TopCaseSides.dxf
58.0 x 198.0 mm
