RMResearch/OpenMPD_Hardware/Cases/1x1 Rear Pillars/Final DXFs/3 mm/leap top base.dxf

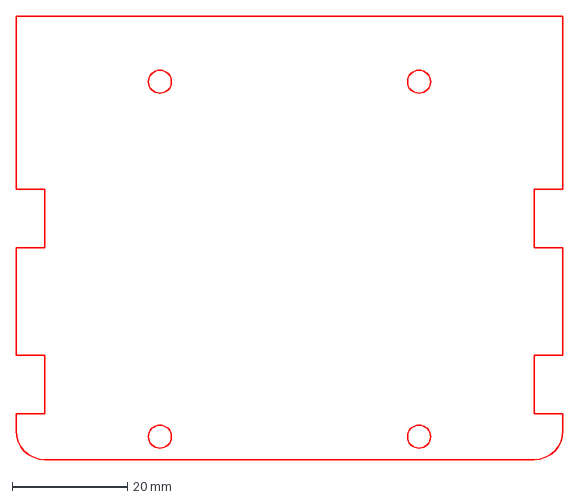
[picture p35: CAD file, 2023-02-06]
Cases/1x1 Rear Pillars/Final DXFs/3 mm/leap top base.dxf
95.0 x 77.0 mm
