RMResearch/OpenMPD_Hardware/Cases/1x1 Rear Pillars/Final DXFs/5mm/2x bottom sides.dxf

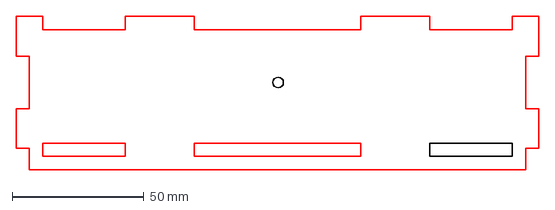
[picture p36: CAD file, 2023-02-06]
Cases/1x1 Rear Pillars/Final DXFs/5mm/2x bottom sides.dxf
198.0 x 58.0 mm
