RMResearch/OpenMPD_Hardware/Cases/2x2/2x2 DXFs/2 2x2 side bracer.dxf

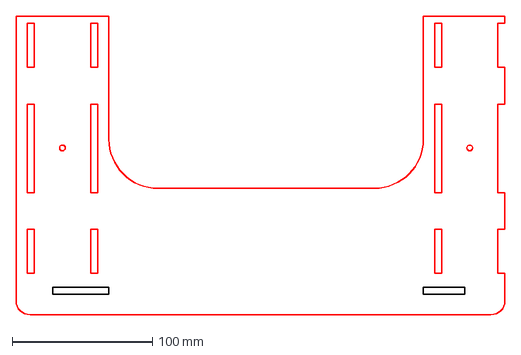
[picture p37: CAD file, 2023-02-06]
Cases/2x2/2x2 DXFs/2 2x2 side bracer.dxf
348.0 x 212.5 mm
