RMResearch/OpenMPD_Hardware/Cases/1x1 Rear Pillars/Final DXFs/3 mm/2x fabric up side.dxf

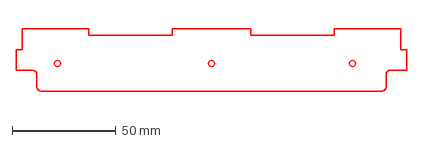
[picture p39: CAD file, 2023-02-06]
Cases/1x1 Rear Pillars/Final DXFs/3 mm/2x fabric up side.dxf
188.0 x 30.0 mm
