RMResearch/OpenMPD_Hardware/Cases/1x1 Rear Pillars/Final DXFs/5mm/back plate.dxf

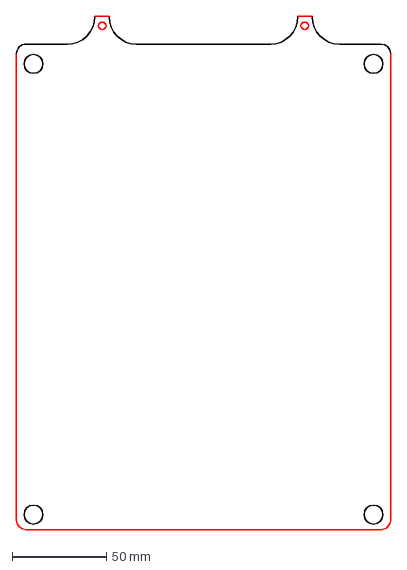
[picture p40: CAD file, 2023-02-06]
Cases/1x1 Rear Pillars/Final DXFs/5mm/back plate.dxf
198.0 x 271.7 mm
