RMResearch/OpenMPD_Hardware/Cases/2x2/2x2 DXFs/back plate big.dxf

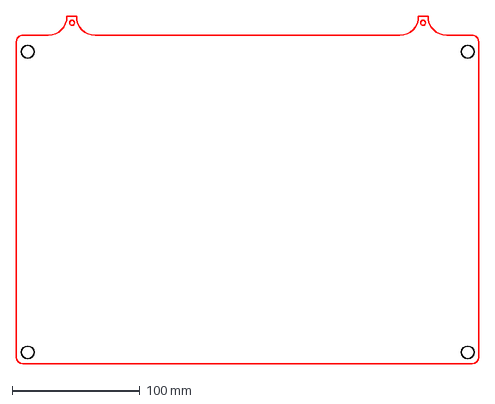
[picture p41: CAD file, 2023-02-06]
Cases/2x2/2x2 DXFs/back plate big.dxf
361.3 x 271.3 mm
