RMResearch/OpenMPD_Hardware/Cases/1x1 middle pillars/2D Models/DXFs/5mm_BottomCaseFront.dxf

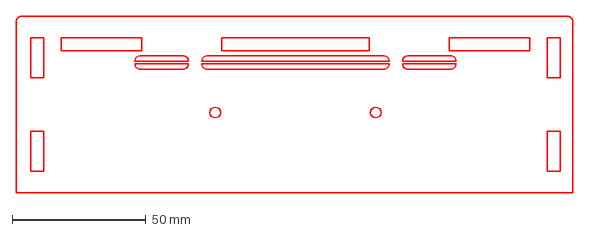
[picture p42: CAD file, 2023-02-06]
Cases/1x1 middle pillars/2D Models/DXFs/5mm_BottomCaseFront.dxf
208.0 x 66.0 mm
