RMResearch/OpenMPD_Hardware/Cases/1x1 Rear Pillars/Final DXFs/3 mm/leap top spacer.dxf

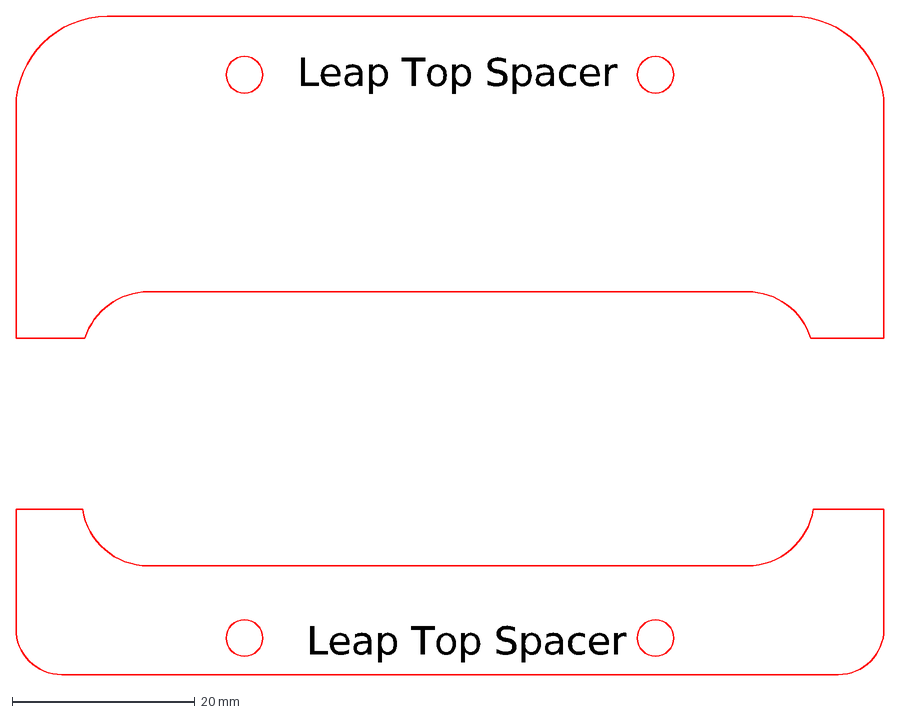
[picture p43: CAD file, 2023-02-06]
Cases/1x1 Rear Pillars/Final DXFs/3 mm/leap top spacer.dxf
Leap Top Spacer
