RMResearch/OpenMPD_Hardware/Cases/1x1 Rear Pillars/Final DXFs/5mm/4x long back spacer.dxf

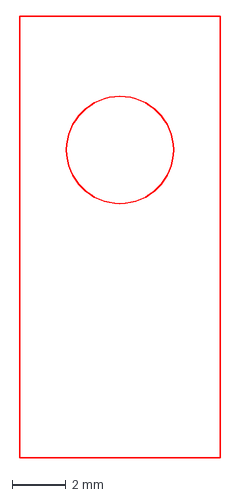
[picture p44: CAD file, 2023-02-06]
Cases/1x1 Rear Pillars/Final DXFs/5mm/4x long back spacer.dxf
7.50 x 16.5 mm
