RMResearch/OpenMPD_Hardware/Cases/1x1 middle pillars/2D Models/DXFs/5mm_7x_HexLock.dxf

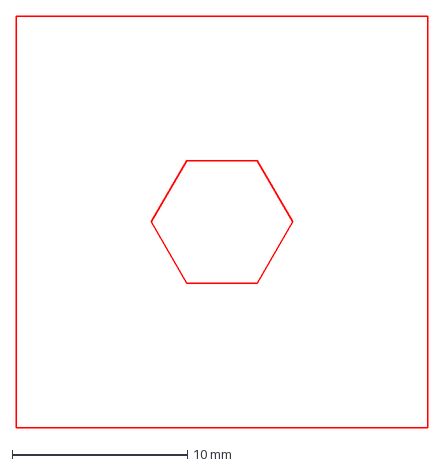
[picture p45: CAD file, 2023-02-06]
Cases/1x1 middle pillars/2D Models/DXFs/5mm_7x_HexLock.dxf
23.5 x 23.5 mm
