RMResearch/OpenMPD_Hardware/Cases/1x1 Rear Pillars/Final DXFs/3 mm/fabric bed.dxf

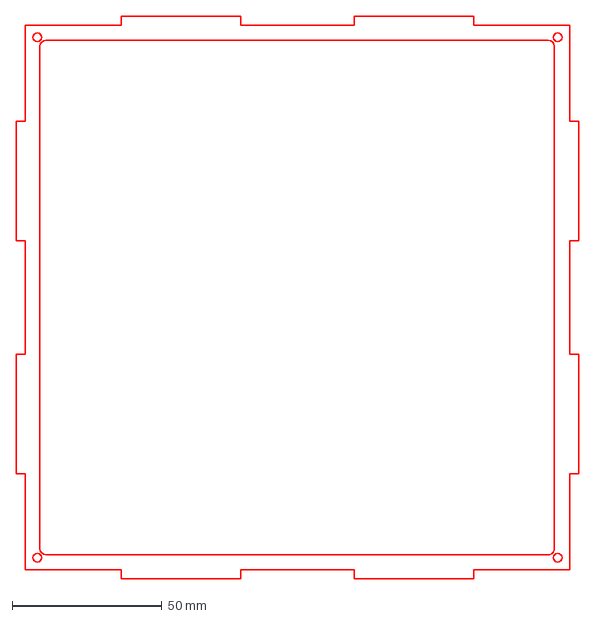
[picture p46: CAD file, 2023-02-06]
Cases/1x1 Rear Pillars/Final DXFs/3 mm/fabric bed.dxf
188.0 x 188.0 mm
