RMResearch/OpenMPD_Hardware/Cases/1x1 Rear Pillars/Final DXFs/5mm/bottom front.dxf

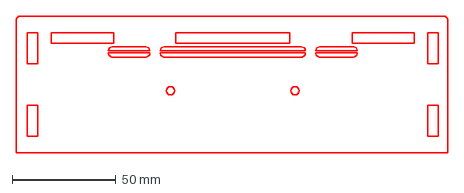
[picture p47: CAD file, 2023-02-06]
Cases/1x1 Rear Pillars/Final DXFs/5mm/bottom front.dxf
208.0 x 66.0 mm
