RMResearch/OpenMPD_Hardware/Cases/1x1 Rear Pillars/Final DXFs/5mm/top back.dxf

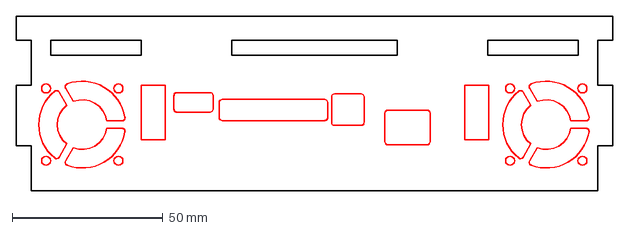
[picture p48: CAD file, 2023-02-06]
Cases/1x1 Rear Pillars/Final DXFs/5mm/top back.dxf
198.0 x 58.0 mm
