RMResearch/OpenMPD_Hardware/(list of files, cad)

Other CAD files:
Cases/1x1 Rear Pillars/Final DXFs/3 mm/KEEP old case new pcb adapter.dxf
Cases/1x1 Rear Pillars/Final DXFs/3 mm/x20 m4 bolt holder.dxf
Cases/1x1 Rear Pillars/Final DXFs/3 mm/x20 m4 nut holder.dxf
Cases/1x1 Rear Pillars/Final DXFs/5mm/2x m6 nut holder A.dxf
Cases/1x1 Rear Pillars/Final DXFs/5mm/2x m6 nut holder B.dxf
Cases/1x1 Rear Pillars/Model/3010fan.iam
Cases/1x1 Rear Pillars/Model/BACK PLATE ASSEMBLY.iam
Cases/1x1 Rear Pillars/Model/BOTTOM ASSEMBLY BOX.iam
Cases/1x1 Rear Pillars/Model/BRACER ASSEMBLIES.iam
Cases/1x1 Rear Pillars/Model/Leap Holder/AP.ipt
Cases/1x1 Rear Pillars/Model/Leap Holder/Attaching Point.ipt
Cases/1x1 Rear Pillars/Model/Leap Holder/Bottom Base.ipt
Cases/1x1 Rear Pillars/Model/Leap Holder/LEAP ASS.iam
Cases/1x1 Rear Pillars/Model/Leap Holder/OldVersions/AP.0005.ipt
Cases/1x1 Rear Pillars/Model/Leap Holder/OldVersions/Attaching Point.0036.ipt
Cases/1x1 Rear Pillars/Model/Leap Holder/OldVersions/Bottom Base.0004.ipt
Cases/1x1 Rear Pillars/Model/Leap Holder/OldVersions/LEAP ASS.0017.iam
Cases/1x1 Rear Pillars/Model/Leap Holder/OldVersions/Top Base.0003.ipt
Cases/1x1 Rear Pillars/Model/Leap Holder/OldVersions/spacer top.0007.ipt
Cases/1x1 Rear Pillars/Model/Leap Holder/OldVersions/spacer.0018.ipt
Cases/1x1 Rear Pillars/Model/Leap Holder/Side.ipt
Cases/1x1 Rear Pillars/Model/Leap Holder/Top Base.ipt
Cases/1x1 Rear Pillars/Model/Leap Holder/case bottom front.ipt
Cases/1x1 Rear Pillars/Model/Leap Holder/leap_motion.ipt
Cases/1x1 Rear Pillars/Model/Leap Holder/spacer top.ipt
Cases/1x1 Rear Pillars/Model/Leap Holder/spacer.ipt
Cases/1x1 Rear Pillars/Model/Part7.ipt
Cases/1x1 Rear Pillars/Model/ipt/2x 2x M6 Nut Holder.ipt
Cases/1x1 Rear Pillars/Model/ipt/2x bolt holder bottom fan.ipt
Cases/1x1 Rear Pillars/Model/ipt/Bottom fabric holder.ipt
Cases/1x1 Rear Pillars/Model/ipt/M2 Nut.ipt
Cases/1x1 Rear Pillars/Model/ipt/M3 Nut.ipt
Cases/1x1 Rear Pillars/Model/ipt/M4 Hex Screw v2 - 25.ipt
Cases/1x1 Rear Pillars/Model/ipt/M4 Nut.ipt
Cases/1x1 Rear Pillars/Model/ipt/M6 nut.ipt
Cases/1x1 Rear Pillars/Model/ipt/NewBoardHolder.ipt
Cases/1x1 Rear Pillars/Model/ipt/PCB Protector for Small Board.ipt
Cases/1x1 Rear Pillars/Model/ipt/V2 Old case New Board Adapter.ipt
Cases/1x1 Rear Pillars/Model/ipt/back bracer.ipt
Cases/1x1 Rear Pillars/Model/ipt/back plate.ipt
Cases/1x1 Rear Pillars/Model/ipt/big hex.ipt
Cases/1x1 Rear Pillars/Model/ipt/big holder.ipt
Cases/1x1 Rear Pillars/Model/ipt/board cover.ipt
Cases/1x1 Rear Pillars/Model/ipt/case bottom back.ipt
Cases/1x1 Rear Pillars/Model/ipt/case bottom front.ipt
Cases/1x1 Rear Pillars/Model/ipt/case bottom sides.ipt
Cases/1x1 Rear Pillars/Model/ipt/case top back.ipt
Cases/1x1 Rear Pillars/Model/ipt/case top front.ipt
Cases/1x1 Rear Pillars/Model/ipt/case top sides.ipt
Cases/1x1 Rear Pillars/Model/ipt/long back plate spacer.ipt
Cases/1x1 Rear Pillars/Model/ipt/short back plate spacer.ipt
Cases/1x1 Rear Pillars/Model/ipt/side bracer.ipt
Cases/1x1 Rear Pillars/Model/leap_motion.ipt
Cases/1x1 Rear Pillars/Model/noctua-nf-a4x10-1.snapshot.1/Noctua-NF-A4x10.ipt
Cases/1x1 middle pillars/2D Models/DXFs/5mm_7x_BoltHolder.dxf
Cases/1x1 middle pillars/Model/BACK PLATE ASSEMBLY.iam
Cases/1x1 middle pillars/Model/BOTTOM ASSEMBLY BOX.iam
Cases/1x1 middle pillars/Model/BRACER ASSEMBLIES.iam
Cases/1x1 middle pillars/Model/ipt/2x 2x M6 Nut Holder.ipt
Cases/1x1 middle pillars/Model/ipt/2x bolt holder bottom fan.ipt
Cases/1x1 middle pillars/Model/ipt/M2 Nut.ipt
Cases/1x1 middle pillars/Model/ipt/M3 Nut.ipt
Cases/1x1 middle pillars/Model/ipt/M4 Hex Screw v2 - 25.ipt
Cases/1x1 middle pillars/Model/ipt/M4 Nut.ipt
Cases/1x1 middle pillars/Model/ipt/M6 nut.ipt
Cases/1x1 middle pillars/Model/ipt/NewBoardHolder.ipt
Cases/1x1 middle pillars/Model/ipt/V2 Old case New Board Adapter.ipt
Cases/1x1 middle pillars/Model/ipt/back bracer.ipt
Cases/1x1 middle pillars/Model/ipt/back plate.ipt
Cases/1x1 middle pillars/Model/ipt/big hex.ipt
Cases/1x1 middle pillars/Model/ipt/big holder.ipt
Cases/1x1 middle pillars/Model/ipt/board cover.ipt
Cases/1x1 middle pillars/Model/ipt/case bottom back.ipt
Cases/1x1 middle pillars/Model/ipt/case bottom front.ipt
Cases/1x1 middle pillars/Model/ipt/case bottom sides.ipt
Cases/1x1 middle pillars/Model/ipt/case top back.ipt
Cases/1x1 middle pillars/Model/ipt/case top front.ipt
Cases/1x1 middle pillars/Model/ipt/case top sides.ipt
Cases/1x1 middle pillars/Model/ipt/long back plate spacer.ipt
Cases/1x1 middle pillars/Model/ipt/short back plate spacer.ipt
Cases/1x1 middle pillars/Model/ipt/side bracer - Copy.ipt
Cases/1x1 middle pillars/Model/ipt/side bracer.ipt
Cases/2x2/2x2 Model/Back Plate.iam
Cases/2x2/2x2 Model/Bottom Box.iam
Cases/2x2/2x2 Model/FINAL 2X2 FABRIC.ipt
Cases/2x2/2x2 Model/Top Box.iam
Cases/2x2/2x2 Model/Total 2x2.iam
Cases/2x2/2x2 Model/ipts/2x 2x M6 Nut Holder.ipt
Cases/2x2/2x2 Model/ipts/2x pcb board holer.ipt
Cases/2x2/2x2 Model/ipts/Part6.ipt
Cases/2x2/2x2 Model/ipts/back bracer.ipt
Cases/2x2/2x2 Model/ipts/back plate.ipt
Cases/2x2/2x2 Model/ipts/big hex.ipt
Cases/2x2/2x2 Model/ipts/big holder.ipt
Cases/2x2/2x2 Model/ipts/board cover.ipt
Cases/2x2/2x2 Model/ipts/case bottom back.ipt
Cases/2x2/2x2 Model/ipts/case bottom front.ipt
Cases/2x2/2x2 Model/ipts/case bottom sides.ipt
Cases/2x2/2x2 Model/ipts/case top back.ipt
Cases/2x2/2x2 Model/ipts/case top front.ipt
Cases/2x2/2x2 Model/ipts/case top sides.ipt
Cases/2x2/2x2 Model/ipts/long back plate spacer.ipt
Cases/2x2/2x2 Model/ipts/short back plate spacer.ipt
Cases/2x2/2x2 Model/ipts/side bracer.ipt
