RMResearch/OpenMPD_Hardware/(list of files, drawings)

Other design files:
Electronics/Array/Headers.SchDoc
Electronics/Array/Motherboard_Top_trimmed.SchDoc
Electronics/Array/Motherboard_trimmed.PrjPcb
Electronics/Array/ShiftAmpilfyEmit.SchDoc
Electronics/Controller/Daughterboard.PrjPcb
Electronics/Controller/Daughterboard_Headers.SchDoc
Electronics/Controller/Daughterboard_Power.SchDoc
