RMResearch/OpenMPD_Hardware/FPGA_3.4.2/src/PinMapping.vhd

library IEEE;
use IEEE.STD_LOGIC_1164.ALL;
use IEEE.STD_LOGIC_ARITH.ALL;
use IEEE.STD_LOGIC_UNSIGNED.ALL;

entity PinMapping is
	port (
		clk		   : in  std_logic;
		address_in  : in  std_logic_vector (7 downto 0);
		address_out : out std_logic_vector (7 downto 0)
	);
end PinMapping;

architecture Behavioral of PinMapping is
	
	signal address_out_s	: std_logic_vector (7 downto 0) := (others => '0');
	signal address_out_d	: std_logic_vector (7 downto 0) := (others => '0');

	subtype PIN is std_logic_vector(7 downto 0);
	type ROM is array (0 to 255) of PIN;
	constant pin_ROM : ROM := (
	"11111001", "11111101", "11110001", "11110101", "11101001", "11101101", "11100001", "11100101", "11011001", "11011101", "11010001", "11010101", "11001001", "11001101", "11000001", "11000101",
	"11111000", "11111100", "11110000", "11110100", "11101000", "11101100", "11100000", "11100100", "11011000", "11011100", "11010000", "11010100", "11001000", "11001100", "11000000", "11000100",
	"11111011", "11111110", "11110011", "11110110", "11101011", "11101110", "11100011", "11100110", "11011011", "11011110", "11010011", "11010110", "11001011", "11001110", "11000011", "11000110",
	"11111010", "11111111", "11110010", "11110111", "11101010", "11101111", "11100010", "11100111", "11011010", "11011111", "11010010", "11010111", "11001010", "11001111", "11000010", "11000111",
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
--		"11101001","11101000","11101011","11101010","10101001","10101000","10101011","10101010","01101001","01101000","01101011","01101010","00101001","00101000","00101011","00101010",
--		"11110101","11110100","11110110","11110111","10110101","10110100","10110110","10110111","01110101","01110100","01110110","01110111","00110101","00110100","00110110","00110111",
--		"11110001","11110000","11110011","11110010","10110001","10110000","10110011","10110010","01110001","01110000","01110011","01110010","00110001","00110000","00110011","00110010",
--		"11111101","11111100","11111110","11111111","10111101","10111100","10111110","10111111","01111101","01111100","01111110","01111111","00111101","00111100","00111110","00111111",
--		"11111001","11111000","11111011","11111010","10111001","10111000","10111011","10111010","01111001","01111000","01111011","01111010","00111001","00111000","00111011","00111010"
	);	
	
begin
	
	address_out <= address_out_s;
	
	process (clk) begin
		if rising_edge(clk) then
			address_out_d <= address_in;--pin_ROM(CONV_INTEGER(address_in));
			address_out_s <= address_out_d;
		end if;
	end process;
end Behavioral;
