RMResearch/OpenMPD_Hardware/FPGA_3.4.2/output_files/SwapFIFO_inst.vhd

SwapFIFO_inst : SwapFIFO PORT MAP (
		clock	 => clock_sig,
		data	 => data_sig,
		rdreq	 => rdreq_sig,
		sclr	 => sclr_sig,
		wrreq	 => wrreq_sig,
		empty	 => empty_sig,
		full	 => full_sig,
		q	 => q_sig
	);
