RMResearch/OpenMPD_Hardware/FPGA_3.4.2/src/PhaseRAM_inst.vhd

PhaseRAM_inst : PhaseRAM PORT MAP (
		data	 => data_sig,
		rdaddress	 => rdaddress_sig,
		rdclock	 => rdclock_sig,
		wraddress	 => wraddress_sig,
		wrclock	 => wrclock_sig,
		wren	 => wren_sig,
		q	 => q_sig
	);
