RMResearch/OpenMPD_Hardware/FPGA_3.4.2/src/PointDataFIFO_inst.vhd

PointDataFIFO_inst : PointDataFIFO PORT MAP (
		clock	 => clock_sig,
		data	 => data_sig,
		rdreq	 => rdreq_sig,
		sclr	 => sclr_sig,
		wrreq	 => wrreq_sig,
		almost_full	 => almost_full_sig,
		empty	 => empty_sig,
		full	 => full_sig,
		q	 => q_sig
	);
