RMResearch/OpenMPD_Hardware/FPGA_3.4.2/src/PhaseCalibration.vhd

library IEEE;
use IEEE.STD_LOGIC_1164.ALL;
use IEEE.STD_LOGIC_ARITH.ALL;
use IEEE.STD_LOGIC_SIGNED.ALL;

entity PhaseCalibration is
	generic (
		BOARD_ID : integer := 0
	);
	port (
		clk			  : in  std_logic;
		phase_in	 	  : in  std_logic_vector (6 downto 0);
		amplitude_in  : in  std_logic_vector (6 downto 0);
		color_in		  : in  std_logic_vector (26 downto 0);
		address_in	  : in  std_logic_vector (7 downto 0);
		phase_out	  : out std_logic_vector (6 downto 0);
		amplitude_out : out std_logic_vector (6 downto 0);
		color_out 	  : out std_logic_vector (26 downto 0)
	);
end PhaseCalibration;

architecture Behavioral of PhaseCalibration is

	subtype CALIB_PHASE is std_logic_vector(6 downto 0);
	type CALIBLATION_ROM is array (0 to 255) of CALIB_PHASE;
	constant calib_rom_0 : CALIBLATION_ROM := (
		"0000000", "0000000", "0000000", "0000000", "0000000", "0000000", "0000000", "0000000", "0000000", "0000000", "0000000", "0000000", "0000000", "0000000", "0000000", "0000000",
		"0000000", "0000000", "0000000", "0000000", "0000000", "0000000", "0000000", "0000000", "0000000", "0000000", "0000000", "0000000", "0000000", "0000000", "0000000", "0000000",
		"0000000", "0000000", "0000000", "0000000", "0000000", "0000000", "0000000", "0000000", "0000000", "0000000", "0000000", "0000000", "0000000", "0000000", "0000000", "0000000",
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
		"0110011","0111000","1110001","1110001","1110101","0110001","1110101","1111000","1111100","0000000","1111010","1101010","1101110","0110001","0101010","1010101",
		"1110101","0110101","1110101","0110001","1110000","0111000","1110101","0111000","1111000","0110111","1111000","1111000","1001110","1011010","1011000","1010101",
		"1110101","1110101","1110001","0110101","0110011","0110011","1110101","1111000","0111000","1110111","0000000","0111010","0100101","0111100","0000101","0000111",
		"0101110","0110001","1110101","1110101","1110101","0110011","1110001","1111010","0111000","0110111","0111100","1110001","1100000","0001000","0100000","0101000",
		"0111000","0110101","1110001","1110011","1110101","1110011","1110101","0111000","1111100","0001010","0111100","0100011","0100101","1001110","1101010","1111000",
		"0110011","0010000","0110001","0110101","1001010","0110001","1111000","1110111","1111100","0111010","0111000","1010001","0011000","0001000","0110001","0010000",
		"0110011","0110000","0110001","1110011","0110001","1110101","1110101","0110011","1111000","1000001","1111000","0111110","0001010","0000011","1110001","1010011",
		"0110000","0110001","0110011","1110011","1110101","1110001","1110001","1110111","0110111","0110111","1111000","0101010","1111100","0111110","0110001","1011000",
		"0110011","1110011","1110001","1110101","0110111","1111000","1110111","1110101","1111000","0111000","0111100","1010101","0101010","1110001","0101110","1011000"
	);
	
	
	signal original		  : std_logic_vector (7 downto 0) := (others => '0');
	signal calib_out  	  : std_logic_vector (6 downto 0) := (others => '0');
	signal amplitude_out_d : std_logic_vector (6 downto 0) := (others => '0');
	signal color_out_d	  : std_logic_vector (26 downto 0) := (others => '0');
	signal phase_out_s 	  : std_logic_vector (7 downto 0) := (others => '0');
	signal amplitude_out_s : std_logic_vector (6 downto 0) := (others => '0');
	signal color_out_s	  : std_logic_vector (26 downto 0) := (others => '0');

begin

	phase_out <= phase_out_s(6 downto 0);
	amplitude_out <= amplitude_out_s;
	color_out <= color_out_s;

	process (clk) begin
		if rising_edge(clk) then
			case BOARD_ID is
				when 0 => 
					calib_out <= calib_rom_0(CONV_INTEGER('0' & address_in));
				when 3 =>
					calib_out <= calib_rom_3(CONV_INTEGER('0' & address_in));
				when 7 =>
					calib_out <= calib_rom_7(CONV_INTEGER('0' & address_in));				
				when others =>
					calib_out <= calib_rom_0(CONV_INTEGER('0' & address_in));
			end case;
					
			original <= ("0" & phase_in);
			phase_out_s <= original - ("0" & calib_out);
			
			amplitude_out_d <= amplitude_in;
			amplitude_out_s <= amplitude_out_d;
			color_out_d <= color_in;
			color_out_s <= color_out_d;
		end if;
	end process;
	 
end Behavioral;
