RMResearch/OpenMPD_Hardware/(commit log)

2023-02-06 Electronics and document
    [Daughterboard.PrjPcb, Daughterboard_Headers.SchDoc, Daughterboard_Power.SchDoc, Headers.SchDoc, Motherboard_Top_trimmed.SchDoc, Motherboard_trimmed.PrjPcb, ShiftAmpilfyEmit.SchDoc]
2023-06-08 Addinf FPGA files to the repository
    [AcoustophoreticBoard.smp_dump.txt]
